na2jpn/rtty_printer/10_rttyprinter(R1.2).pdf

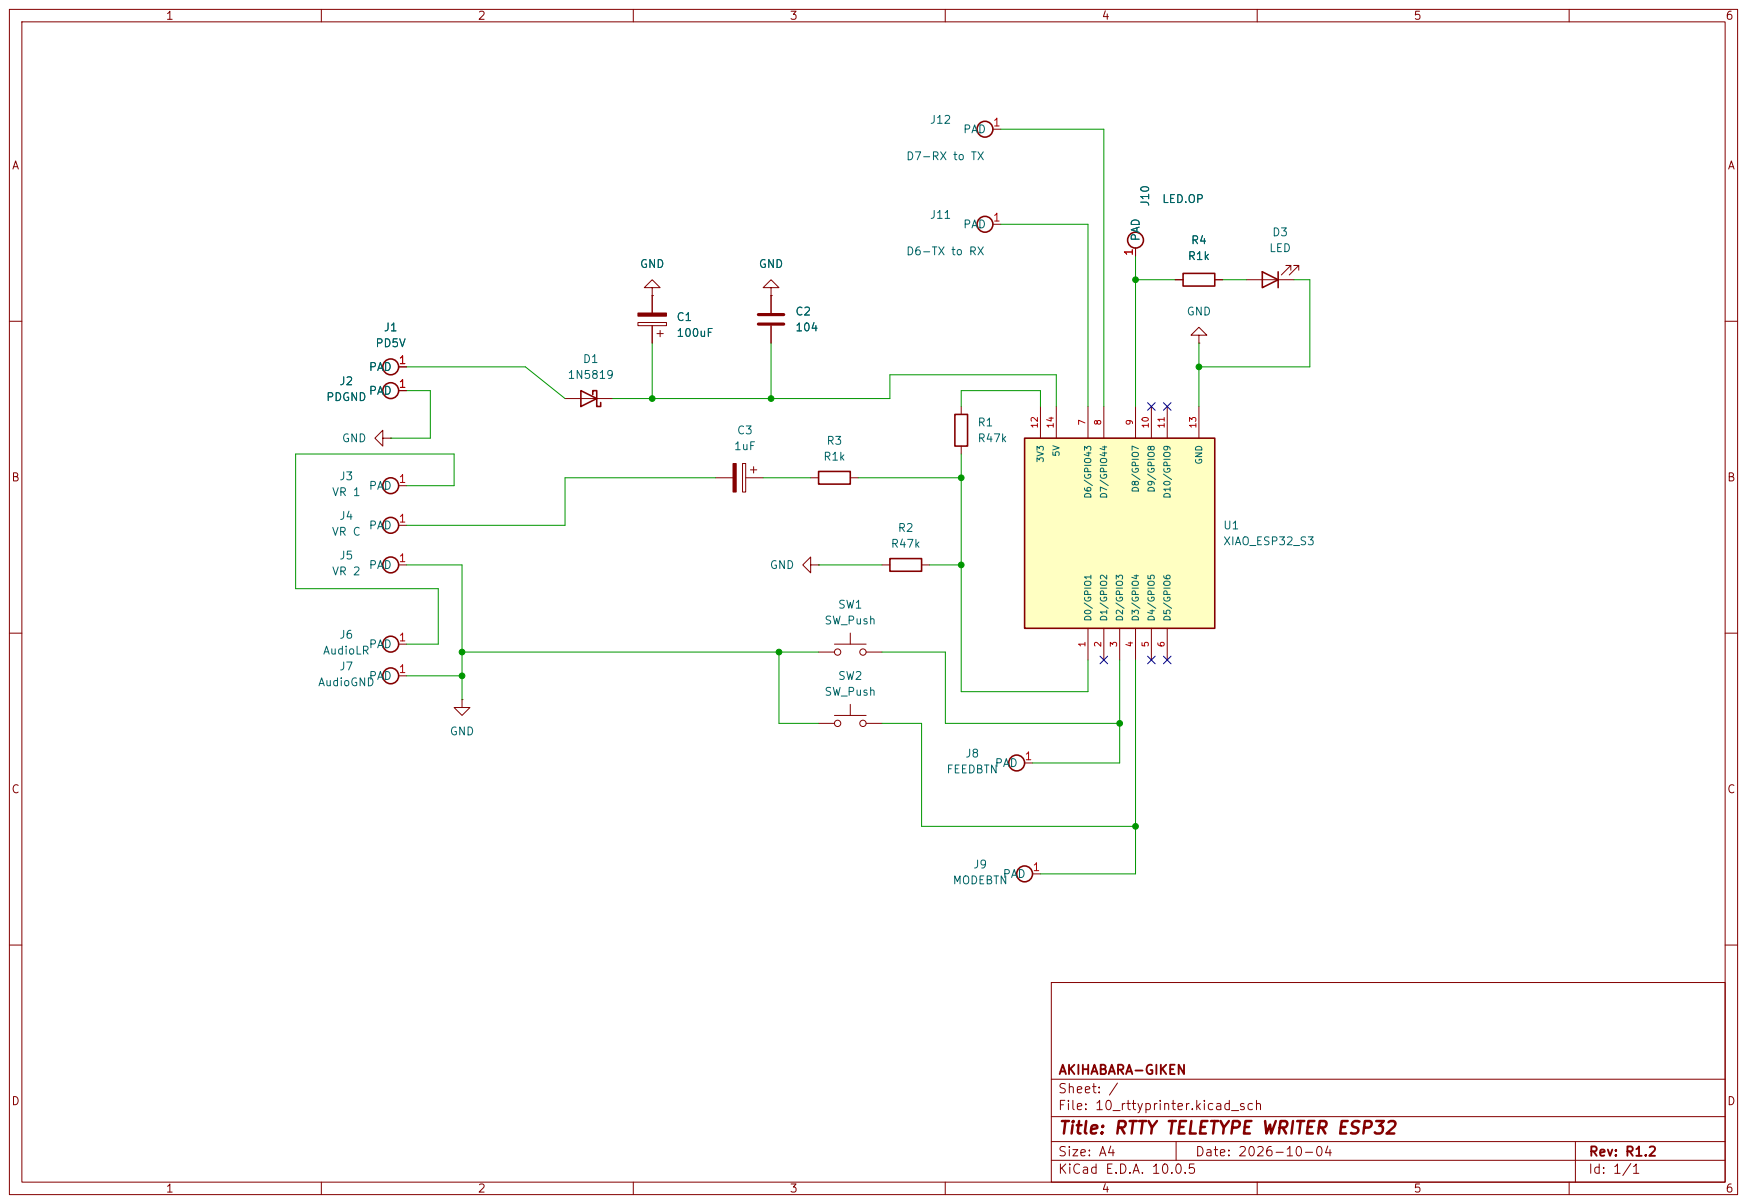
[picture p1: page 1]

AKIHABARA-GIKEN
Sheet: /
File: 10_rttyprinter.kicad_sch
Title: RTTY TELETYPE WRITER ESP32

Size: A4 | Rev: R1.2
KiCad E.D.A. 10.0.5 | Id: 1/1

U1 : Seeed Studio XIAO ESP32S3（通常版）

R1 : 抵抗 1/4W 47kΩ
R2 : 抵抗 1/4W 47kΩ
R3 : 抵抗 1/4W 1kΩ
R4 : 抵抗 1/4W 1kΩ (LEDによって)

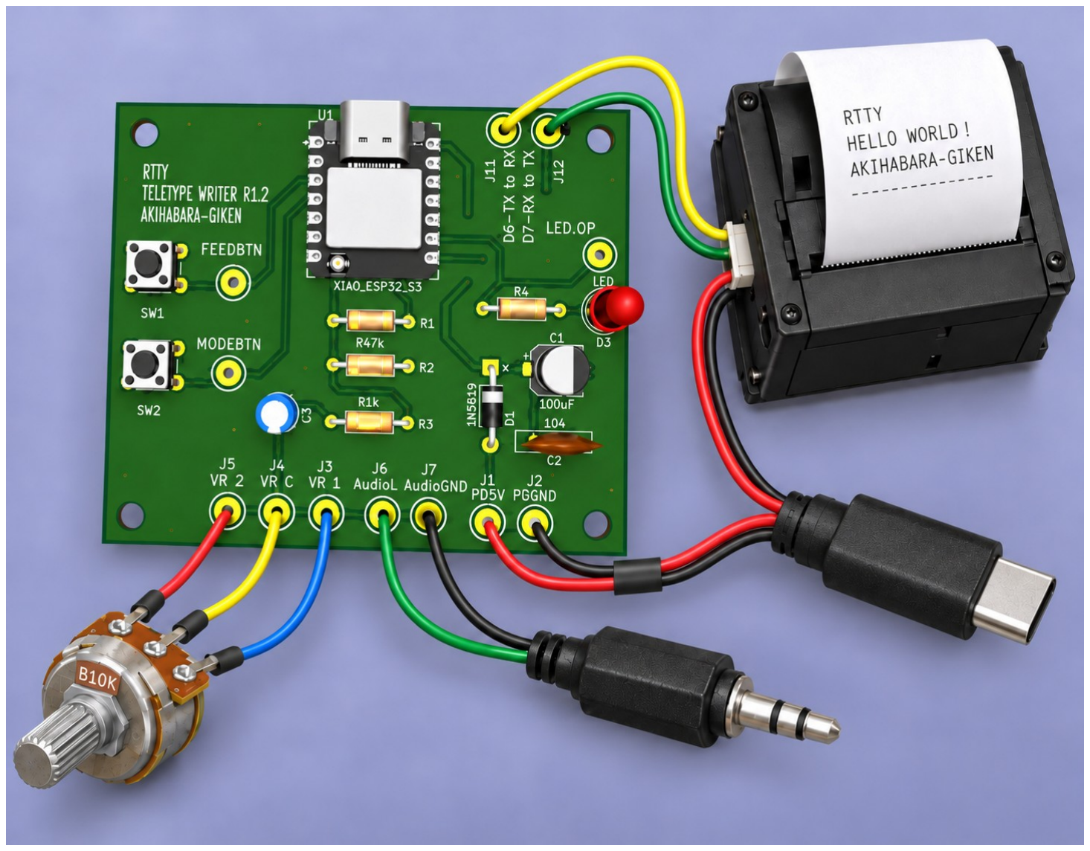
[picture p2: figure]

C1 : アルミ電解コンデンサ 100µF 16V

### C2 : セラミックコンデンサ 0.1µF（104） C3 : アルミ電解コンデンサ 1µF 50V

### D1 : ショットキーバリアダイオード 1N5819 (代替は低損失なもの)

D3 : LED 赤 5mm

### SW1 : タクトスイッチ 2ピン モーメンタリ（FEED）

### SW2 : タクトスイッチ 2ピン モーメンタリ（MODE）

Panel : VR B10K（10kΩ Bカーブ）
Panel : 3.5mm ステレオジャック

### Printer : 58mm サーマルプリンターモジュール

TTL / RS232 / USB対応

### 電源 5～9V

TTL通信 9600bps 8N1

Power : USB-C PD 5V / 3A
Power : PDトリガーケーブル 5V
USB-C → DC 5.5×2.5mm
Panel : DCジャック 5.5×2.5mm
Panel : 電源スイッチ

J1 : PD 5V入力

J2 : PD GND
J3 : VR 1
J4 : VR C（ワイパー）
J5 : VR 2
J6 : Audio Signal
J7 : Audio GND
J11 : D6 / TX → Printer RX J12 : D7 / RX ← Printer TX

## Sample Priter-Unit 試用品： https://www.amazon.co.jp/dp/B0CL6QBJ8T? Model EM5820
